Ahmed-Xavier/Autonomous-outdoor-RC/ros2_ws/src/simulation/worlds/models/silesia_ring/materials/textures/silesia_ring.png

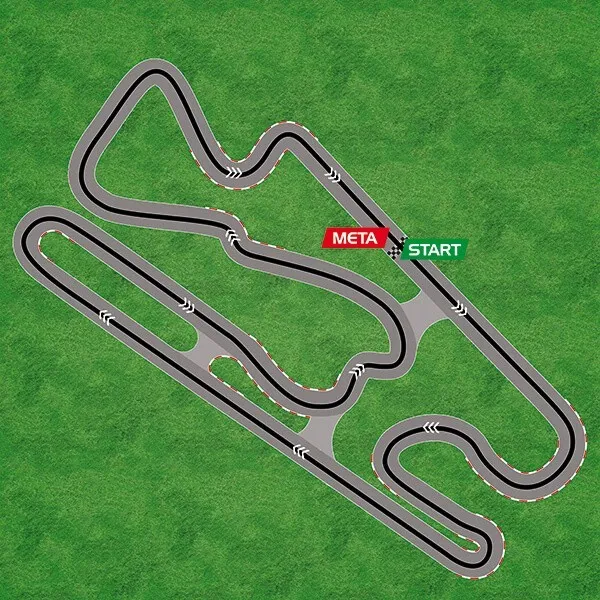
ros2_ws/src/simulation/worlds/models/silesia_ring/materials/textures/silesia_ring.png
