Ahmed-Xavier/Autonomous-outdoor-RC/docs/notes.txt

This file is for Ahmed the owner.

# ROS 2 Environment

Always source before running ROS 2 commands:

source /opt/ros/jazzy/setup.bash

# micro-ROS

Start the micro-ROS agent on the Raspberry Pi:

ros2 run micro_ros_agent micro_ros_agent udp4 --port 8888 -v4
(verbose from 0 to 6 depends on the level of debugging)

The ESP32 currently connects to the agent over Wi-Fi.

## Current ESP32 Topics

Encoder:

ros2 topic echo /esp32/encoder

Check encoder publishing rate:

ros2 topic hz /esp32/encoder

Current target rate: approximately 20 Hz.

Motor command:

ros2 topic pub -r 10 /esp32/motor_cmd std_msgs/msg/Int16 "{data: 100}"

Stop motor:

ros2 topic pub --once /esp32/motor_cmd std_msgs/msg/Int16 "{data: 0}"

Servo command:

ros2 topic pub --once /esp32/servo_cmd std_msgs/msg/Int16 "{data: 50}"

Current servo calibration:

28 = maximum RIGHT
48 = CENTER
68 = maximum LEFT

# Map / Navigation

Start map server:

ros2 run nav2_map_server map_server --ros-args -p yaml_filename:=$HOME/map.yaml

Activate it:

ros2 run nav2_util lifecycle_bringup map_server

# Foxglove

Start the Foxglove bridge:

ros2 launch foxglove_bridge foxglove_bridge_launch.xml

Foxglove has been tested for map visualization, including a Google Earth screenshot as a development/test map source.

#vehicle control 

ros2 run vehicle_control vehicle_controller

#vehicle description

ros2 launch vehicle_bringup description.launch.py

# Hardware

Main computer:
- Raspberry Pi 4 Model B
- Ubuntu 24.04
- ROS 2 Jazzy

Low-level controller:
- ESP32

Motor:
- JGA25-370
- 12 V motor supply

Motor driver:
- L298N

GPS:
- GT-U7

IMU:
- BNO055

Camera:
- Hikvision USB camera

# Hardware Pinout

## JGA25-370 motor + encoder cable

Yellow = Encoder A -> ESP32 GPIO 33
White = Encoder B -> ESP32 GPIO 32
Blue = Encoder VCC -> 5 V
Green = Encoder GND -> GND
Black = Motor negative -> GND / motor supply negative
Red = Motor positive -> +12 V

## L298N motor driver

IN1 -> ESP32 GPIO 26
IN2 -> ESP32 GPIO 27
ENA/PWM -> ESP32 GPIO 25

## Steering servo

Signal -> ESP32 GPIO 14

# Current Development Status

Working/tested (real car):
- ESP32 Wi-Fi micro-ROS connection
- L298N motor control
- Steering servo control
- JGA25-370 encoder acquisition (~20 Hz)
- ROS 2 topic communication
- Foxglove visualization
- GT-U7 GPS integration
- BNO055 IMU integration (~50 Hz)
- LiDAR integration
- EKF localization (local + global, navsat_transform)
- Autonomous GPS waypoint navigation

Simulation (active focus — Gazebo headless in WSL + Foxglove):
- Real car URDF running in Gazebo headless
- Teleop control via /cmd_vel (steering + speed) working
- Next: sensor data (GPS, IMU, LiDAR) in simulation
- Then: full navigation stack in simulation
- Then: camera integration
- Then: /cmd_vel arbiter node (chooses between teleop and autonomy)

In progress:
- Sensor simulation in Gazebo
- Camera perception (lane keeping, stop sign detection)
- /cmd_vel arbiter
