Ahmed-Xavier/Autonomous-outdoor-RC/ros2_ws/src/simulation/worlds/models/silesia_ring/meshes/silesia_ring.obj

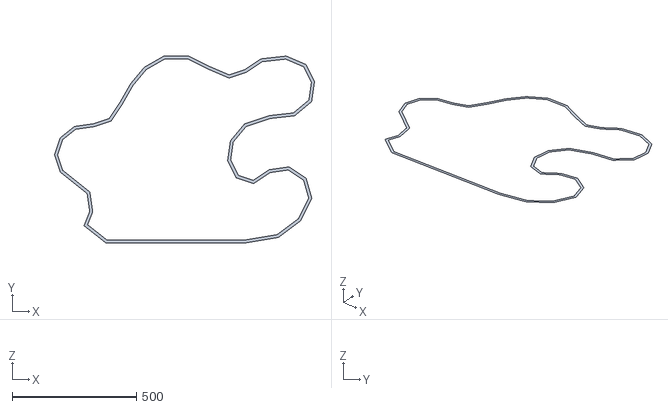
[picture p2: CAD file, 2026-10-10]
ros2_ws/src/simulation/worlds/models/silesia_ring/meshes/silesia_ring.obj
1047.9 x 753.2 x 0
