Ahmed-Xavier/Autonomous-outdoor-RC/ros2_ws/src/vehicle_description/meshes/body_collision.stl

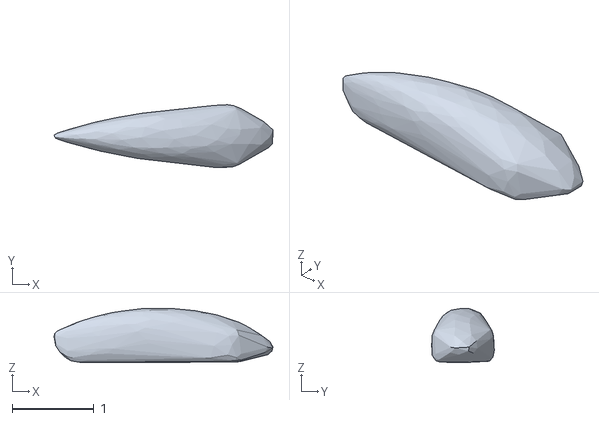
[picture p3: CAD file, 2026-10-06]
ros2_ws/src/vehicle_description/meshes/body_collision.stl
2.69 x 0.768 x 0.667
