Ahmed-Xavier/Autonomous-outdoor-RC/ros2_ws/src/vehicle_description/meshes/stl/body_shell.stl

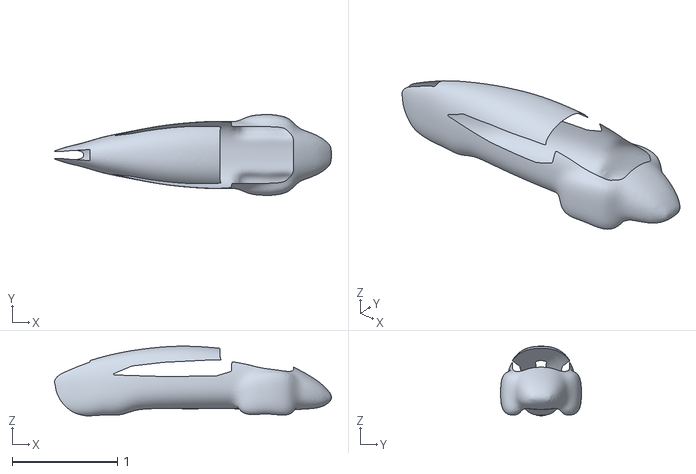
[picture p4: CAD file, 2026-10-06]
ros2_ws/src/vehicle_description/meshes/stl/body_shell.stl
2.64 x 0.77 x 0.664
