Ahmed-Xavier/Autonomous-outdoor-RC/ros2_ws/src/simulation/worlds/models/silesia_ring/meshes/track_boundaries.obj

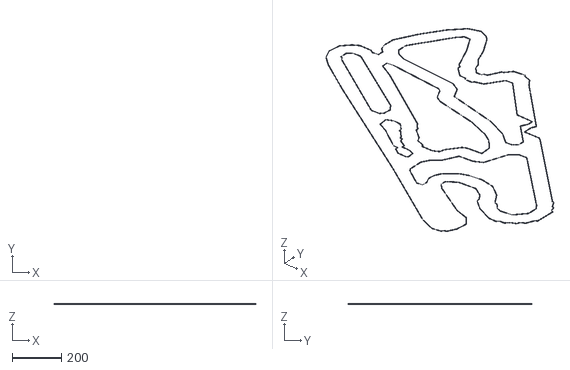
[picture p5: CAD file, 2026-10-06]
ros2_ws/src/simulation/worlds/models/silesia_ring/meshes/track_boundaries.obj
817.7 x 744.7 x 0.18
