Ahmed-Xavier/Autonomous-outdoor-RC/ros2_ws/src/vehicle_description/meshes/stl/tail_tip.stl

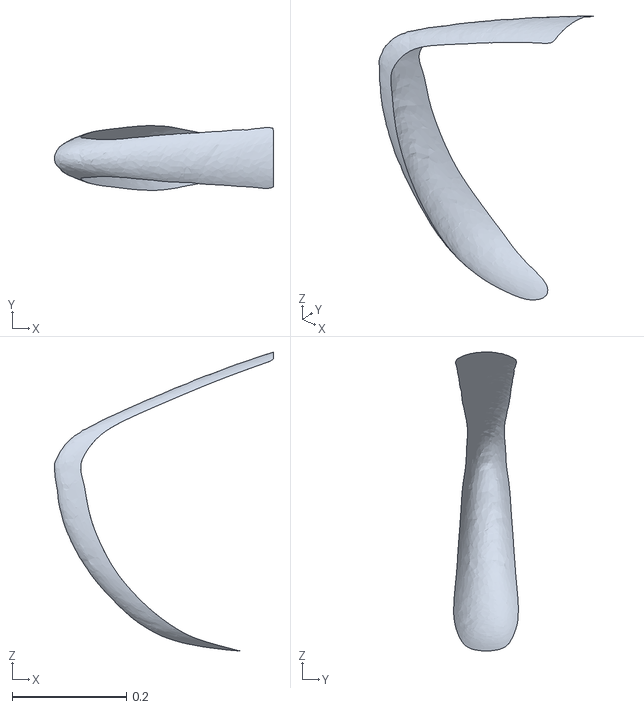
[picture p6: CAD file, 2026-10-06]
ros2_ws/src/vehicle_description/meshes/stl/tail_tip.stl
0.384 x 0.113 x 0.524
