Ahmed-Xavier/Autonomous-outdoor-RC/ros2_ws/src/vehicle_description/meshes/stl/canopy.stl

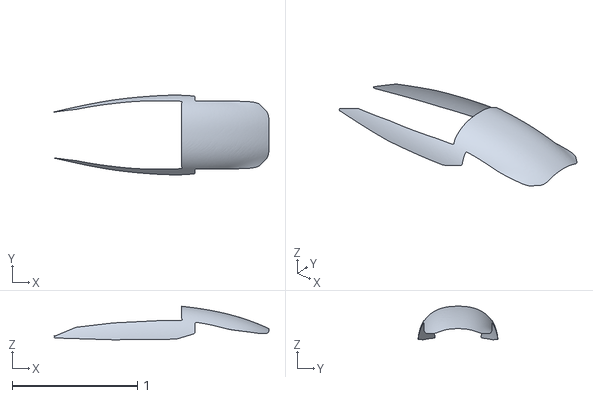
[picture p7: CAD file, 2026-10-06]
ros2_ws/src/vehicle_description/meshes/stl/canopy.stl
1.72 x 0.637 x 0.268
