Ahmed-Xavier/Autonomous-outdoor-RC/Real car urdf/urdf/enimia_black.urdf

<?xml version="1.0"?>
<!--
  ENIMIA - Black Edition (ENIM Team Tunisia) - Prototype Shell Eco-marathon      v3 (surface lissee)
  Carrosserie reconstruite a partir des silhouettes des vues de dessus et de cote :
    - profil de toit / bas de caisse releve pixel par pixel sur la vue de cote
    - largeur (plan) relevee sur la vue de dessus
    - 2 carenes de roues avant (contour releve sur la vue de cote + vue de dessus)
    - vitrage (cockpit + vitres laterales) et bord de fuite rouge separes
  v3 : profils C2 (B-splines), raccords carenes/fuselage arrondis, lissage de Taubin,
       maillages COLLADA (.dae) avec normales par sommet -> ombrage lisse dans RViz/Gazebo.
       Copies STL (ombrage plat) dans meshes/stl/ pour les outils qui ne lisent pas le DAE.
  Dimensions : L 2684 x l 770 x h 695 mm, empattement 1704 mm,
               voie avant 567 mm, masse 25 kg
  Porte-a-faux : avant 593 mm, arriere 387 mm
  Roues : avant R 210 mm (limite par la carene), arriere R 180 mm (arc du pneu)

  Arbre cinematique :
    base_footprint (sol, milieu de l'empattement)
      └─ base_link (chassis, a hauteur d'axe avant)
           ├─ body_link               (coque + vitrage + bord de fuite, fixe : contient tout)
           ├─ front_left_steer_link   (revolute)   └─ front_left_wheel_link  (continuous)
           ├─ front_right_steer_link  (revolute)   └─ front_right_wheel_link (continuous)
           └─ rear_wheel_link         (continuous, motrice)
  Reperes REP-103 : X avant, Y gauche, Z haut. Unites SI.
-->
<robot name="enimia_black">

  <!-- ===================== Materiaux ===================== -->
  <material name="carbon_black"><color rgba="0.07 0.07 0.08 0.55"/></material>
  <material name="glass"><color rgba="0.20 0.32 0.40 0.35"/></material>
  <material name="tail_red"><color rgba="0.80 0.08 0.08 0.9"/></material>
  <material name="aluminium"><color rgba="0.75 0.76 0.78 1.0"/></material>
  <material name="tire"><color rgba="0.10 0.10 0.10 1.0"/></material>
  <material name="rim"><color rgba="0.82 0.82 0.84 1.0"/></material>
  <material name="floor"><color rgba="0.35 0.30 0.70 1.0"/></material>
  <material name="battery"><color rgba="0.85 0.80 0.15 1.0"/></material>

  <!-- ===================== Base ===================== -->
  <link name="base_footprint"/>

  <joint name="base_footprint_joint" type="fixed">
    <parent link="base_footprint"/>
    <child link="base_link"/>
    <origin xyz="0 0 0.21" rpy="0 0 0"/>
  </joint>

  <!-- Chassis : plancher, traverse avant, colonne de direction, arceau, bras arriere, batterie -->
  <link name="base_link">
    <visual>
      <origin xyz="0.0955 0.0000 -0.0850" rpy="0 0 0"/>
      <geometry><box size="1.3 0.28 0.02"/></geometry>
      <material name="floor"/>
    </visual>
    <visual>
      <origin xyz="0.8520 0.0000 0.0000" rpy="0 0 0"/>
      <geometry><box size="0.04 0.48 0.03"/></geometry>
      <material name="aluminium"/>
    </visual>
    <visual>
      <origin xyz="0.8020 0.0000 0.0000" rpy="0 0 0"/>
      <geometry><box size="0.05 0.05 0.16"/></geometry>
      <material name="aluminium"/>
    </visual>
    <visual>
      <origin xyz="0.4455 0.0000 0.3400" rpy="0 0 0"/>
      <geometry><box size="0.03 0.39 0.03"/></geometry>
      <material name="aluminium"/>
    </visual>
    <visual>
      <origin xyz="0.4455 0.1800 0.1500" rpy="0 0 0"/>
      <geometry><box size="0.03 0.03 0.39"/></geometry>
      <material name="aluminium"/>
    </visual>
    <visual>
      <origin xyz="0.4455 -0.1800 0.1500" rpy="0 0 0"/>
      <geometry><box size="0.03 0.03 0.39"/></geometry>
      <material name="aluminium"/>
    </visual>
    <visual>
      <origin xyz="-0.7020 0.0350 -0.0575" rpy="0 0.18 0"/>
      <geometry><box size="0.31 0.015 0.025"/></geometry>
      <material name="aluminium"/>
    </visual>
    <visual>
      <origin xyz="-0.7020 -0.0350 -0.0575" rpy="0 0.18 0"/>
      <geometry><box size="0.31 0.015 0.025"/></geometry>
      <material name="aluminium"/>
    </visual>
    <visual>
      <origin xyz="-0.5320 0.0000 -0.0300" rpy="0 0 0"/>
      <geometry><box size="0.22 0.07 0.05"/></geometry>
      <material name="battery"/>
    </visual>
    <collision>
      <origin xyz="0.0955 0 -0.0850" rpy="0 0 0"/>
      <geometry><box size="1.3 0.28 0.02"/></geometry>
    </collision>
    <inertial>
      <origin xyz="-0.05 0 -0.050" rpy="0 0 0"/>
      <mass value="12.7"/>
      <inertia ixx="0.137583" ixy="0" ixz="0" iyy="2.42358" iyz="0" izz="2.4765"/>
    </inertial>
  </link>

  <!-- ===================== Coque (corps) ===================== -->
  <!-- Maillages exprimes dans le repere sol (origine au milieu de l'empattement) -->
  <link name="body_link">
    <visual>
      <origin xyz="0 0 0" rpy="0 0 0"/>
      <geometry><mesh filename="package://enimia_black_description/meshes/body_shell.dae"/></geometry>
      <material name="carbon_black"/>
    </visual>
    <visual>
      <origin xyz="0 0 0" rpy="0 0 0"/>
      <geometry><mesh filename="package://enimia_black_description/meshes/canopy.dae"/></geometry>
      <material name="glass"/>
    </visual>
    <visual>
      <origin xyz="0 0 0" rpy="0 0 0"/>
      <geometry><mesh filename="package://enimia_black_description/meshes/tail_tip.dae"/></geometry>
      <material name="tail_red"/>
    </visual>
    <collision>
      <origin xyz="0 0 0" rpy="0 0 0"/>
      <geometry><mesh filename="package://enimia_black_description/meshes/body_collision.stl"/></geometry>
    </collision>
    <inertial>
      <origin xyz="0.1939 0 0.329146" rpy="0 0 0"/>
      <mass value="7.0"/>
      <inertia ixx="0.587735" ixy="0.00022506" ixz="0.084203" iyy="3.65022" iyz="0" izz="3.67245"/>
    </inertial>
  </link>

  <joint name="body_joint" type="fixed">
    <parent link="base_link"/>
    <child link="body_link"/>
    <origin xyz="0 0 -0.21" rpy="0 0 0"/>
  </joint>

  <!-- ===================== Roue avant gauche (dans sa carene) ===================== -->
  <link name="front_left_steer_link">
    <visual>
      <origin xyz="0 -0.040 0" rpy="0 0 0"/>
      <geometry><box size="0.06 0.04 0.10"/></geometry>
      <material name="aluminium"/>
    </visual>
    <inertial>
      <origin xyz="0 -0.040 0" rpy="0 0 0"/>
      <mass value="0.4"/>
      <inertia ixx="0.000386667" ixy="0" ixz="0" iyy="0.000453333" iyz="0" izz="0.000173333"/>
    </inertial>
  </link>

  <joint name="front_left_steer_joint" type="revolute">
    <parent link="base_link"/>
    <child link="front_left_steer_link"/>
    <origin xyz="0.8520 0.2835 0" rpy="0 0 0"/>
    <axis xyz="0 0 1"/>
    <limit lower="-0.21" upper="0.21" effort="20" velocity="2.0"/>
    <dynamics damping="0.1" friction="0.05"/>
  </joint>

  <link name="front_left_wheel_link">
    <visual>
      <origin xyz="0 0 0" rpy="1.5708 0 0"/>
      <geometry><cylinder radius="0.21" length="0.035"/></geometry>
      <material name="tire"/>
    </visual>
    <visual>
      <origin xyz="0 0 0" rpy="1.5708 0 0"/>
      <geometry><cylinder radius="0.175" length="0.039"/></geometry>
      <material name="rim"/>
    </visual>
    <collision>
      <origin xyz="0 0 0" rpy="1.5708 0 0"/>
      <geometry><cylinder radius="0.21" length="0.035"/></geometry>
    </collision>
    <inertial>
      <origin xyz="0 0 0" rpy="0 0 0"/>
      <mass value="1.0"/>
      <inertia ixx="0.0179333" ixy="0" ixz="0" iyy="0.0356625" iyz="0" izz="0.0179333"/>
    </inertial>
  </link>

  <joint name="front_left_wheel_joint" type="continuous">
    <parent link="front_left_steer_link"/>
    <child link="front_left_wheel_link"/>
    <origin xyz="0 0 0" rpy="0 0 0"/>
    <axis xyz="0 1 0"/>
    <limit effort="10" velocity="40"/>
    <dynamics damping="0.01" friction="0.0"/>
  </joint>

  <!-- ===================== Roue avant droite (dans sa carene) ===================== -->
  <link name="front_right_steer_link">
    <visual>
      <origin xyz="0 0.040 0" rpy="0 0 0"/>
      <geometry><box size="0.06 0.04 0.10"/></geometry>
      <material name="aluminium"/>
    </visual>
    <inertial>
      <origin xyz="0 0.040 0" rpy="0 0 0"/>
      <mass value="0.4"/>
      <inertia ixx="0.000386667" ixy="0" ixz="0" iyy="0.000453333" iyz="0" izz="0.000173333"/>
    </inertial>
  </link>

  <joint name="front_right_steer_joint" type="revolute">
    <parent link="base_link"/>
    <child link="front_right_steer_link"/>
    <origin xyz="0.8520 -0.2835 0" rpy="0 0 0"/>
    <axis xyz="0 0 1"/>
    <limit lower="-0.21" upper="0.21" effort="20" velocity="2.0"/>
    <dynamics damping="0.1" friction="0.05"/>
  </joint>

  <link name="front_right_wheel_link">
    <visual>
      <origin xyz="0 0 0" rpy="1.5708 0 0"/>
      <geometry><cylinder radius="0.21" length="0.035"/></geometry>
      <material name="tire"/>
    </visual>
    <visual>
      <origin xyz="0 0 0" rpy="1.5708 0 0"/>
      <geometry><cylinder radius="0.175" length="0.039"/></geometry>
      <material name="rim"/>
    </visual>
    <collision>
      <origin xyz="0 0 0" rpy="1.5708 0 0"/>
      <geometry><cylinder radius="0.21" length="0.035"/></geometry>
    </collision>
    <inertial>
      <origin xyz="0 0 0" rpy="0 0 0"/>
      <mass value="1.0"/>
      <inertia ixx="0.0179333" ixy="0" ixz="0" iyy="0.0356625" iyz="0" izz="0.0179333"/>
    </inertial>
  </link>

  <joint name="front_right_wheel_joint" type="continuous">
    <parent link="front_right_steer_link"/>
    <child link="front_right_wheel_link"/>
    <origin xyz="0 0 0" rpy="0 0 0"/>
    <axis xyz="0 1 0"/>
    <limit effort="10" velocity="40"/>
    <dynamics damping="0.01" friction="0.0"/>
  </joint>

  <!-- ===================== Roue arriere motrice (moteur-roue) ===================== -->
  <link name="rear_wheel_link">
    <visual>
      <origin xyz="0 0 0" rpy="1.5708 0 0"/>
      <geometry><cylinder radius="0.18" length="0.035"/></geometry>
      <material name="tire"/>
    </visual>
    <visual>
      <origin xyz="0 0 0" rpy="1.5708 0 0"/>
      <geometry><cylinder radius="0.145" length="0.039"/></geometry>
      <material name="rim"/>
    </visual>
    <visual>
      <origin xyz="0 0 0" rpy="1.5708 0 0"/>
      <geometry><cylinder radius="0.07" length="0.06"/></geometry>
      <material name="aluminium"/>
    </visual>
    <collision>
      <origin xyz="0 0 0" rpy="1.5708 0 0"/>
      <geometry><cylinder radius="0.18" length="0.035"/></geometry>
    </collision>
    <inertial>
      <origin xyz="0 0 0" rpy="0 0 0"/>
      <mass value="2.5"/>
      <inertia ixx="0.0142319" ixy="0" ixz="0" iyy="0.02732" iyz="0" izz="0.0142319"/>
    </inertial>
  </link>

  <joint name="rear_wheel_joint" type="continuous">
    <parent link="base_link"/>
    <child link="rear_wheel_link"/>
    <origin xyz="-0.8520 0 -0.030" rpy="0 0 0"/>
    <axis xyz="0 1 0"/>
    <limit effort="15" velocity="40"/>
    <dynamics damping="0.01" friction="0.0"/>
  </joint>

  <!-- ===================== Capteurs ===================== -->
  <!--
    Repere REP-103: X avant, Y gauche, Z haut.
    Positions de simulation: a remplacer par les mesures reelles des supports.
  -->

  <!-- IMU: proche du centre du chassis, sur la ligne mediane. -->
  <link name="imu_link"/>
  <joint name="imu_joint" type="fixed">
    <parent link="base_link"/>
    <child link="imu_link"/>
    <origin xyz="0.000 0.000 0.060" rpy="0 0 0"/>
  </joint>

  <!-- GPS/GNSS: au-dessus de la coque, sur la ligne mediane. -->
  <link name="gps_link"/>
  <joint name="gps_joint" type="fixed">
    <parent link="base_link"/>
    <child link="gps_link"/>
    <origin xyz="-0.100 0.000 0.455" rpy="0 0 0"/>
  </joint>

  <!--
    LiDAR: 8 deg incline vers le bas pour mieux voir les petits cones
    et obstacles bas du Shell Eco-marathon.
    +8 deg de pitch autour de Y => axe X du LiDAR pointe legerement vers le sol.
  -->
  <link name="lidar_link"/>
  <joint name="lidar_joint" type="fixed">
    <parent link="base_link"/>
    <child link="lidar_link"/>
    <origin xyz="0.100 0.000 0.445" rpy="0 0.139626 0"/>
  </joint>

  <!-- ===================== Gazebo (adherence pneus) ===================== -->
  <gazebo reference="front_left_wheel_link"><mu1>1.0</mu1><mu2>1.0</mu2></gazebo>
  <gazebo reference="front_right_wheel_link"><mu1>1.0</mu1><mu2>1.0</mu2></gazebo>
  <gazebo reference="rear_wheel_link"><mu1>1.0</mu1><mu2>1.0</mu2></gazebo>

</robot>
