Ahmed-Xavier/Autonomous-outdoor-RC/(commit log)

2026-09-27 Add vehicle_bringup package: LiDAR + Foxglove bridge launch, ignore build artifacts
2026-09-28 esp32 frimware: encoder, motor, servo via microros agent (wireless)
2026-09-29 low level updated (imu added)
2026-09-30 urdf added
    [rc_car.urdf.xacro]
2026-09-30 Add car URDF, vehicle_state node, description launch; invert steering
    [vehicle_controller_node.py, vehicle_state_node.py]
2026-09-30 Calibrate odometry and update steering limits
2026-10-01 Restructure into layered architecture (description/drivers/localization/control/navigation/bringup)
    [vehicle_controller.yaml]
2026-10-01 Update localization and vehicle configuration
    [rc_car.urdf.xacro]
2026-10-03 Lidar integration
    [rc_car.urdf.xacro]
2026-10-04 Fix lidar scan mode and navigation launch
2026-10-04 Add LIDAR safety stop, map-frame waypoints, remove old follower and click_to_goal
2026-10-06 real car urdf
    [body_collision.stl, body_shell.stl, canopy.stl, enimia_black.urdf, tail_tip.stl]
2026-10-06 Add ENIMIA IMU GPS and tilted LiDAR sensor frames
    [enimia_black.urdf]
2026-10-06 Replace RC description with ENIMIA and add simulation package
    [body_collision.stl, body_shell.stl, canopy.stl, enimia.urdf, rc_car.urdf.xacro, tail_tip.stl]
2026-10-06 Add simulation world and update vehicle model
    [empty.sdf, enimia.urdf]
2026-10-06 Silesia ring world added
    [model.sdf, silesia_ring.obj, silesia_ring.sdf, track_boundaries.obj]
2026-10-06 track boudaries updated
    [track_boundaries.obj]
2026-10-06 Update simulation and Silesia Ring world
    [enimia.urdf]
2026-10-06 steering added
2026-10-06 Link vehicle_controller to Gazebo via esp32_sim_bridge; add drive plugins
    [enimia.urdf]
2026-10-07 sensor data + navigation added to simulation
    [enimia.urdf, silesia_ring.sdf]
2026-10-07 few simulation fixes
    [enimia.urdf, silesia_ring.sdf]
2026-10-07 deleting few lines from the urdf
    [enimia.urdf]
2026-10-07 sim fixes
    [enimia.urdf]
2026-10-07 Simulation works
    [model.sdf]
2026-10-10 Add lightweight autonomous challenge test world
    [autonomous_challenge.sdf]
2026-10-10 Replace square placeholder with scaled track ribbon mesh
    [silesia_ring.obj]
2026-10-10 Use asphalt material for scaled track mesh
2026-10-10 Use track-shaped visual and collision geometry
    [model.sdf]
2026-10-10 Add terrain below Silesia Ring track mesh
    [silesia_ring.sdf]
2026-10-10 Correct road ribbon offset geometry
    [silesia_ring.obj]
